Arturrito63/4Channel-DVM/Documents/encoder mode.jpg

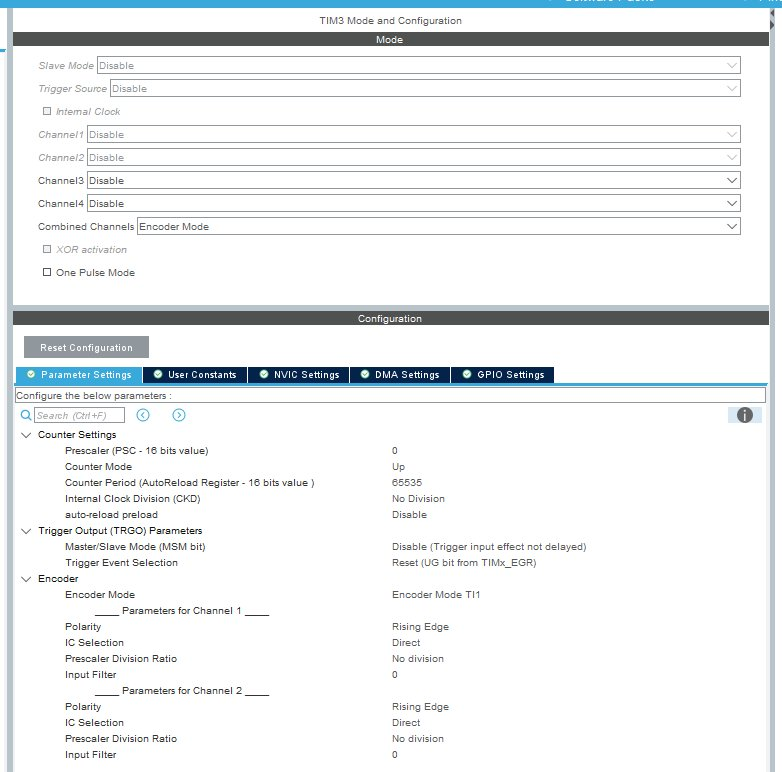
Documents/encoder mode.jpg
