Arturrito63/4Channel-DVM/Documents/ILI3941 timing.jpg

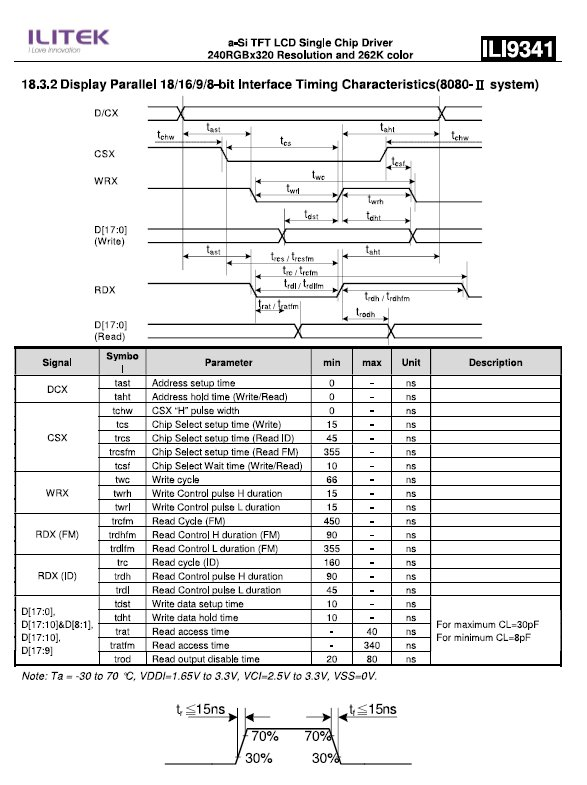
Documents/ILI3941 timing.jpg
