Arturrito63/4Channel-DVM/Documents/MLT024Q50-T6.png

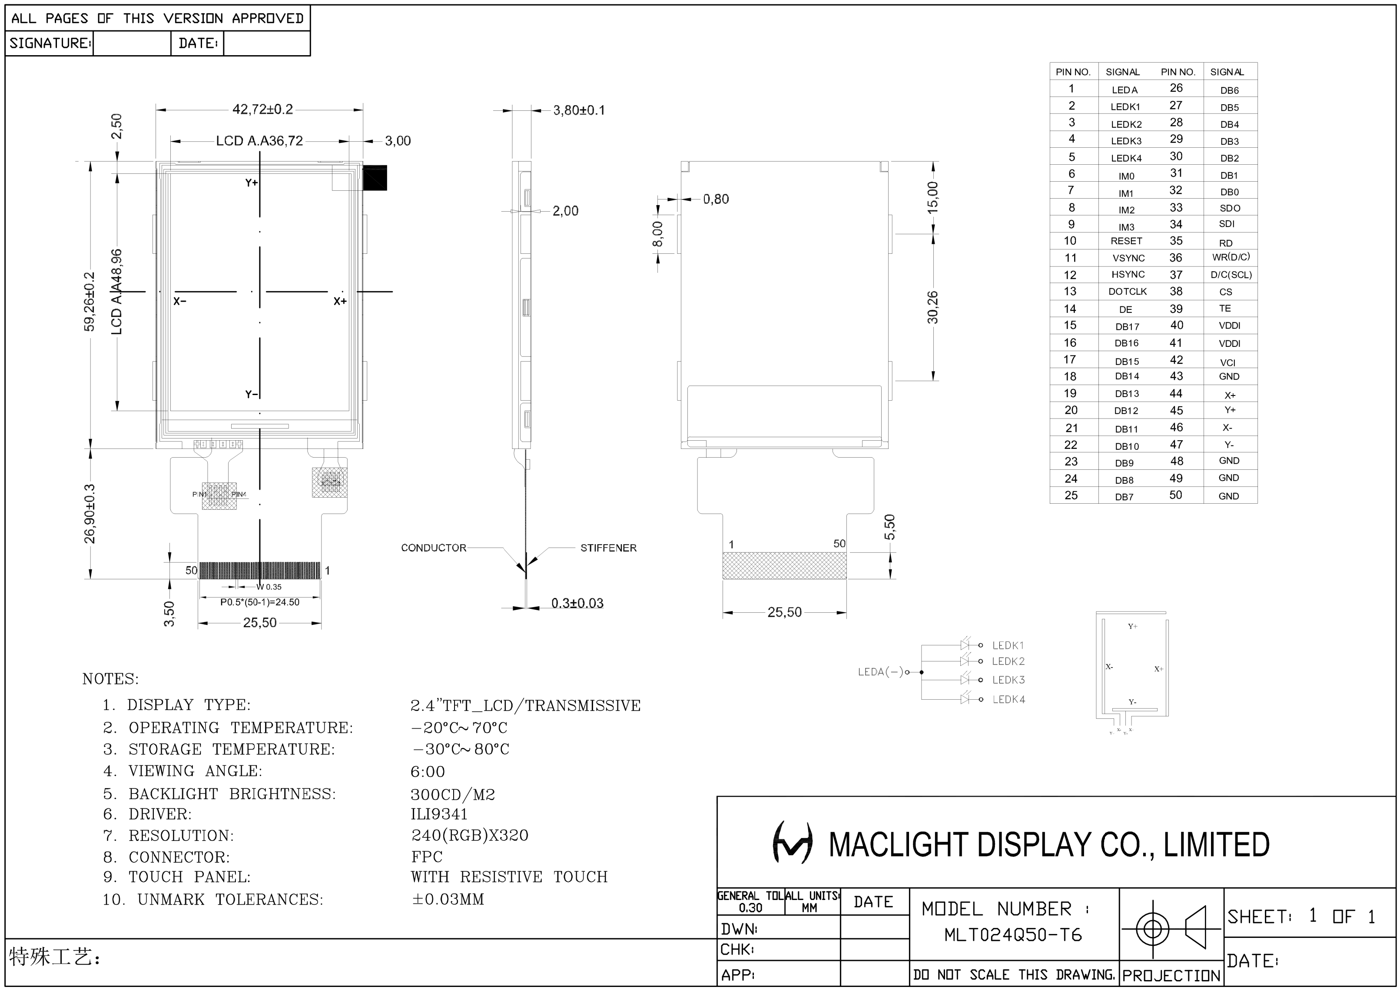
Documents/MLT024Q50-T6.png
