Arturrito63/4Channel-DVM/Documents/STM32F103-Blue-Pill.pdf

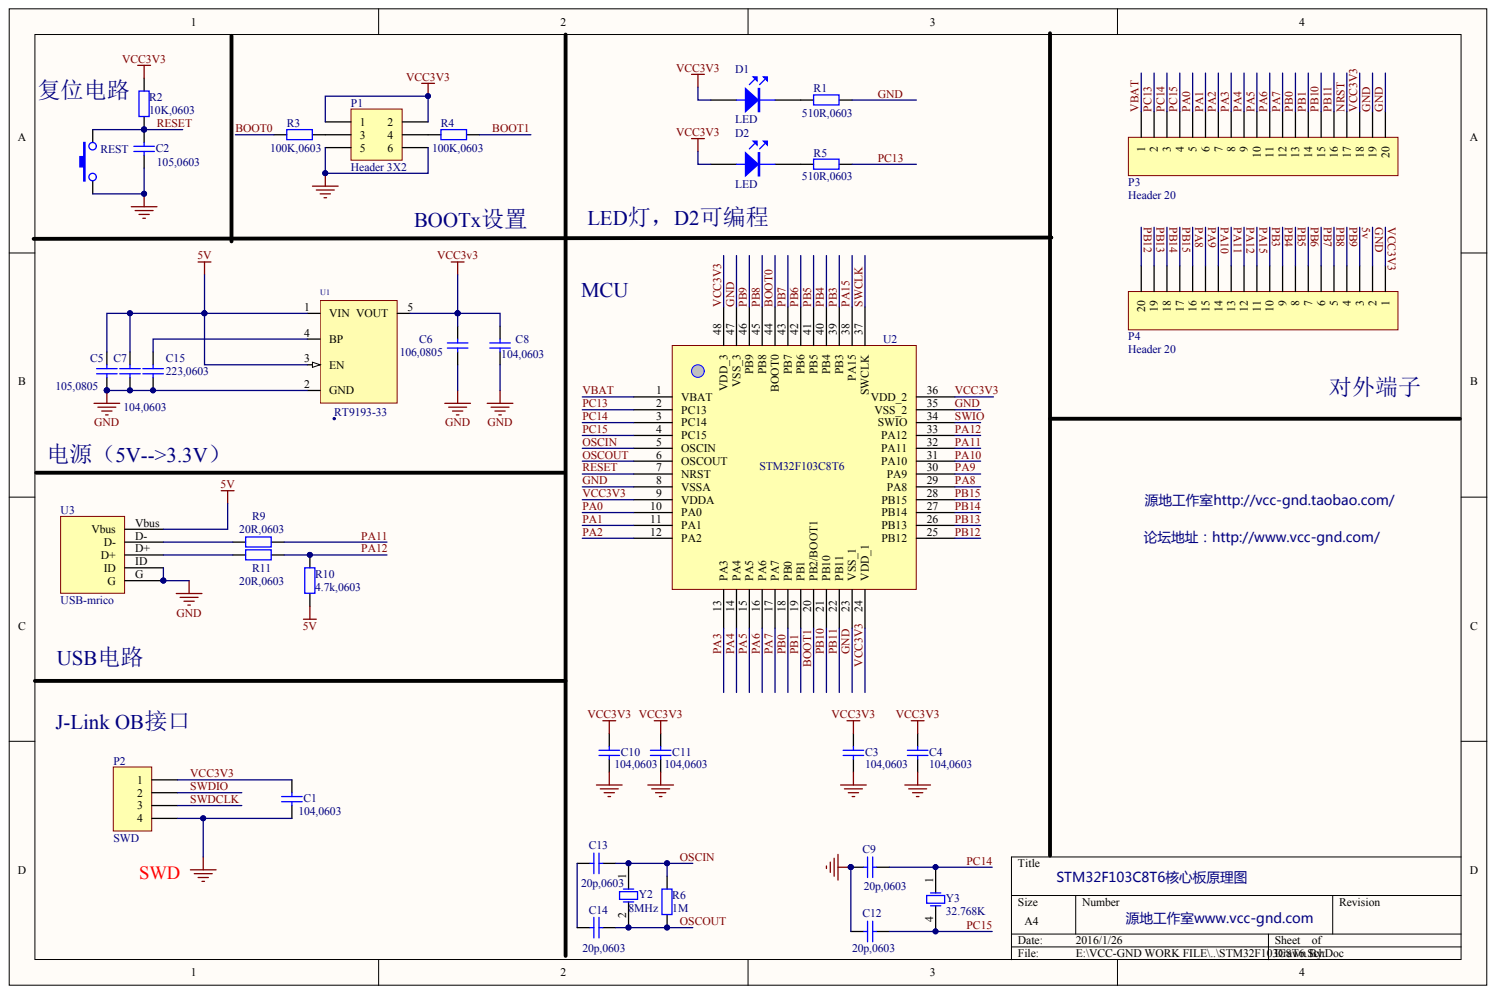
[picture p10: page 1]

源地工作室http://vcc-gnd.taobao.com/

论坛地址：http://www.vcc-gnd.com/

源地工作室www.vcc-gnd.com
