Arturrito63/4Channel-DVM/Documents/4-Channel-DVM.pdf

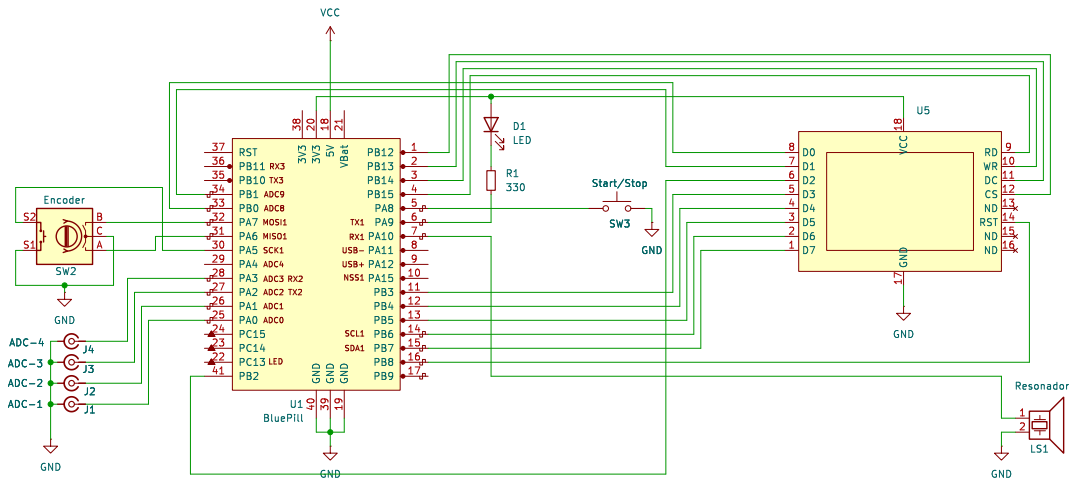
[picture p11: page 1]
