Arturrito63/4Channel-DVM/Documents/ILI9341-ciclos.pdf

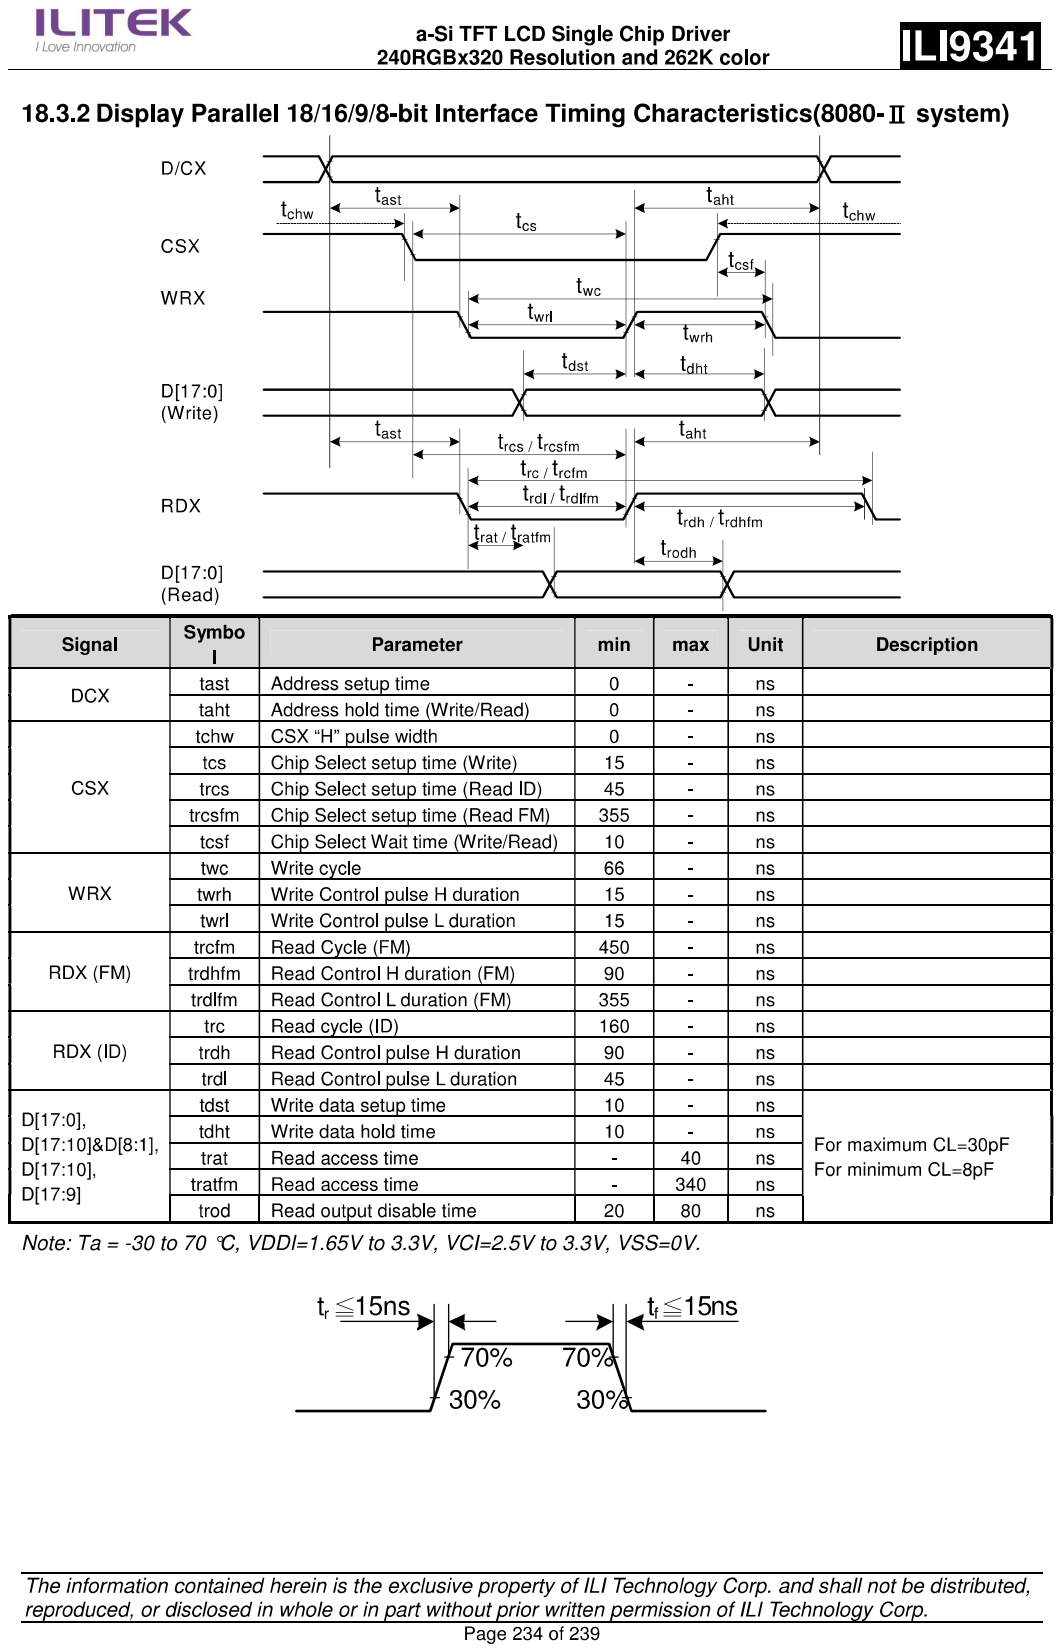
[picture p12: page 1]
