Arturrito63/4Channel-DVM/4Channel-DVM.ioc

Mcu.UserName=STM32F103C8Tx
PA13.Signal=SYS_JTMS-SWDIO
PA14.Signal=SYS_JTCK-SWCLK
PB0.Signal=ADCx_IN8
PB1.Signal=ADCx_IN9
PB12.GPIO_Label=BOTON
PB12.Signal=GPXTI12
PB13.GPIO_Label=ENC-B
PB13.Signal=GPXTI13
PB14.GPIO_Label=ENC-A
PB14.Signal=GPXTI14
PC13-TAMPER-RTC.GPIO_Label=LED
PC13-TAMPER-RTC.Signal=GPIO_Output
PC14-OSC32_IN.Signal=RCC_OSC32_IN
PC15-OSC32_OUT.Signal=RCC_OSC32_OUT
PD0-OSC_IN.Signal=RCC_OSC_IN
PD1-OSC_OUT.Signal=RCC_OSC_OUT
