Arturrito63/4Channel-DVM/Core/Inc/main.h

#define LED_Pin GPIO_PIN_13
#define LED_GPIO_Port GPIOC
#define BOTON_Pin GPIO_PIN_5
#define BOTON_GPIO_Port GPIOA
#define BOTON_EXTI_IRQn EXTI9_5_IRQn
#define ENC_A_Pin GPIO_PIN_6
#define ENC_A_GPIO_Port GPIOA
#define ENC_B_Pin GPIO_PIN_7
#define ENC_B_GPIO_Port GPIOA
#define START_Pin GPIO_PIN_8
#define START_GPIO_Port GPIOA
#define START_EXTI_IRQn EXTI9_5_IRQn
#define LED_START_Pin GPIO_PIN_9
#define LED_START_GPIO_Port GPIOA
#define BEEP_Pin GPIO_PIN_10
#define BEEP_GPIO_Port GPIOA
