Arturrito63/4Channel-DVM/Core/Src/ili9341_parallel.c

/*
MIT License

Copyright (c) 2020 Avra Mitra

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
THE SOFTWARE IS PROVIDED "AS IS", WITHOUT WARRANTY OF ANY KIND, EXPRESS OR
IMPLIED, INCLUDING BUT NOT LIMITED TO THE WARRANTIES OF MERCHANTABILITY,
FITNESS FOR A PARTICULAR PURPOSE AND NONINFRINGEMENT. IN NO EVENT SHALL THE
AUTHORS OR COPYRIGHT HOLDERS BE LIABLE FOR ANY CLAIM, DAMAGES OR OTHER
LIABILITY, WHETHER IN AN ACTION OF CONTRACT, TORT OR OTHERWISE, ARISING FROM,
OUT OF OR IN CONNECTION WITH THE SOFTWARE OR THE USE OR OTHER DEALINGS IN THE
SOFTWARE.
*/

#include <stdlib.h>
#include <ili9341_parallel.h>

//TFT width and height default global variables
uint16_t ili_tftwidth = 240;
uint16_t ili_tftheight = 320;



/**
 * Set an area for drawing on the display with start row,col and end row,col.
 * User don't need to call it usually, call it only before some functions who don't call it by default.
 * @param x1 start column address.
 * @param y1 start row address.
 * @param x2 end column address.
 * @param y2 end row address.
 */
void ili_set_address_window(uint16_t x1, uint16_t y1, uint16_t x2, uint16_t y2)
{
	_ili_write_command_8bit(ILI_CASET);

	ILI_DC_DAT;
	ILI_WRITE_8BIT((uint8_t)(x1 >> 8));
	ILI_WRITE_8BIT((uint8_t)x1);
	ILI_WRITE_8BIT((uint8_t)(x2 >> 8));
	ILI_WRITE_8BIT((uint8_t)x2);


	_ili_write_command_8bit(ILI_PASET);
	ILI_DC_DAT;
	ILI_WRITE_8BIT((uint8_t)(y1 >> 8));
	ILI_WRITE_8BIT((uint8_t)y1);
	ILI_WRITE_8BIT((uint8_t)(y2 >> 8));
	ILI_WRITE_8BIT((uint8_t)y2);

	_ili_write_command_8bit(ILI_RAMWR);
}



/*
 * Render a character glyph on the display. Called by `_ili_draw_string_main()`
 * User need NOT call it
 */
void _ili_render_glyph(uint16_t x, uint16_t y, uint16_t fore_color, uint16_t back_color, const tImage *glyph, uint8_t is_bg)
{
	uint16_t width = 0, height = 0;

	width = glyph->width;
	height = glyph->height;

	uint16_t temp_x = x;
	uint16_t temp_y = y;

	uint8_t mask = 0x80;
	uint8_t bit_counter = 0;

	const uint8_t *glyph_data_ptr = (const uint8_t *)(glyph->data);
	uint8_t glyph_data = 0;

	// font bitmaps are stored in column major order (scanned from left-to-right, not the conventional top-to-bottom)
	// as font glyphs have heigher height than width, this scanning saves some storage.
	// So, we also render in left-to-right manner.

	// Along x axis (width)
	for (int i = 0; i < width; i++)
	{
		// Along y axis (height)
		for (int j = 0; j < height; j++)
		{

			// load new data only when previous byte (or word, depends on glyph->dataSize) is completely traversed by the mask
			// bit_counter = 0 means glyph_data is completely traversed by the mask
			if (bit_counter == 0)
			{
				glyph_data = *glyph_data_ptr++;
				bit_counter = glyph->dataSize;
			}
			// Decrement bit counter
			bit_counter--;

			//If pixel is blank
			if (glyph_data & mask)
			{
				//Has background color (not transparent bg)
				if (is_bg)
				{
					ili_draw_pixel(temp_x, temp_y, back_color);
				}
			}

			//if pixel is not blank
			else
			{
				ili_draw_pixel(temp_x, temp_y, fore_color);
			}

			glyph_data <<= 1;
			temp_y++;
		}

		//New col starts. So, row is set to initial value and col is increased by one
		temp_y = y;
		temp_x++;

		//Reset the bit counter cause we're moving to next column, so we start with a new byte
		bit_counter = 0;
	}
}



/**
 * Renders a string by drawing each character glyph from the passed string.
 * Called by `ili_draw_string()` and `ili_draw_string_withbg()`.
 * Text is wrapped automatically if it hits the screen boundary.
 * x_padding and y_padding defines horizontal and vertical distance (in px) between two characters
 * is_bg=1 : Text will habe background color,   is_bg=0 : Text will have transparent background
 * User need NOT call it.
 */

void _ili_draw_string_main(uint16_t x, uint16_t y, char *str, uint16_t fore_color, uint16_t back_color, const tFont *font, uint8_t is_bg)
{
	uint16_t x_temp = x;
	uint16_t y_temp = y;

	uint8_t x_padding = 0;
	uint8_t y_padding = 0;
	const tImage *img = {0};
	uint16_t width = 0, height = 0;



	while (*str)
	{
		if (*str == '\n')
		{
			x_temp = x;					//go to first col
			y_temp += (font->chars[0].image->height + y_padding);	//go to next row (row height = height of space)
		}

		else if (*str == '\t')
		{
			x_temp += 4 * (font->chars[0].image->height + y_padding);	//Skip 4 spaces (width = width of space)
		}
		else
		{
			for (uint8_t i = 0; i < font->length; i++)
			{
				if (font->chars[i].code == *str)
				{
					img = font->chars[i].image;
					break;
				}
			}
			// No glyph (img) found, so return from this function
			if (img == NULL)
			{
				return;
			}

			width = img->width;
			height = img->height;

			if(y_temp + (height + y_padding) > ili_tftheight - 1)	//not enough space available at the bottom
				return;
			if (x_temp + (width + x_padding) > ili_tftwidth - 1)	//not enough space available at the right side
			{
				x_temp = x;					//go to first col
				y_temp += (height + y_padding);	//go to next row
			}


			if (is_bg)
				_ili_render_glyph(x_temp, y_temp, fore_color, back_color, img, 1);
			else
				_ili_render_glyph(x_temp, y_temp, fore_color, back_color, img, 0);
			x_temp += (width + x_padding);		//next char position
		}


		str++;
	}
}


/**
 * Draws a character at a given position, fore color, back color.
 * @param x Start col address
 * @param y Start row address
 * @param character the ASCII character to be drawn
 * @param fore_color foreground color
 * @param back_color background color
 * @param font Pointer to the font of the character
 * @param is_bg Defines if character has background or not (transparent)
 */
void ili_draw_char(uint16_t x, uint16_t y, char character, uint16_t fore_color, uint16_t back_color, const tFont *font, uint8_t is_bg)
{
	const tImage *img = NULL;
	for (uint8_t i = 0; i < font->length; i++)
	{
		if (font->chars[i].code == character)
		{
			img = font->chars[i].image;
			break;
		}
	}
	// No glyph (img) found, so return from this function
	if (img == NULL)
	{
		return;
	}
	if (is_bg)
		_ili_render_glyph(x, y, fore_color, back_color, img, 1);
	else
		_ili_render_glyph(x, y, fore_color, back_color, img, 0);
}


/**
 * Draws a string on the display with `font` and `color` at given position.
 * Background of this string is transparent
 * @param x Start col address
 * @param y Start y address
 * @param str pointer to the string to be drawn
 * @param color 16-bit RGB565 color of the string
 * @param font Pointer to the font of the string
 */
void ili_draw_string(uint16_t x, uint16_t y, char *str, uint16_t color, const tFont *font)
{
	_ili_draw_string_main(x, y, str, color, 0, font, 0);
}


/**
 * Draws a string on the display with `font`, `fore_color`, and `back_color` at given position.
 * The string has background color
 * @param x Start col address
 * @param y Start y address
 * @param str pointer to the string to be drawn
 * @param foe_color 16-bit RGB565 color of the string
 * @param back_color 16-bit RGB565 color of the string's background
 * @param font Pointer to the font of the string
 */
void ili_draw_string_withbg(uint16_t x, uint16_t y, char *str, uint16_t fore_color, uint16_t back_color, const tFont *font)
{
	_ili_draw_string_main(x, y, str, fore_color, back_color, font, 1);
}


/**
 * Draw a bitmap image on the display
 * @param x Start col address
 * @param y Start row address
 * @param bitmap Pointer to the image data to be drawn
 */
// void ili_draw_bitmap_old(uint16_t x, uint16_t y, const tImage16bit *bitmap)
// {
// 	uint16_t width = 0, height = 0;
// 	width = bitmap->width;
// 	height = bitmap->height;

// 	uint16_t total_pixels = width * height;

// 	ili_set_address_window(x, y, x + width-1, y + height-1);

// 	ILI_DC_DAT;
// 	for (uint16_t pixels = 0; pixels < total_pixels; pixels++)
// 	{
// 		ILI_WRITE_8BIT((uint8_t)(bitmap->data[pixels] >> 8));
// 		ILI_WRITE_8BIT((uint8_t)bitmap->data[pixels]);
// 	}
// }

void ili_draw_bitmap(uint16_t x, uint16_t y, const tImage *bitmap)
{
	uint16_t width = 0, height = 0;
	width = bitmap->width;
	height = bitmap->height;

	uint16_t total_pixels = width * height;

	ili_set_address_window(x, y, x + width-1, y + height-1);

	ILI_DC_DAT;
	for (uint16_t pixels = 0; pixels < total_pixels; pixels++)
	{
		ILI_WRITE_8BIT((uint8_t)(bitmap->data[2*pixels]));
		ILI_WRITE_8BIT((uint8_t)(bitmap->data[2*pixels + 1]));
	}
}


/**
 * Fills `len` number of pixels with `color`.
 * Call ili_set_address_window() before calling this function.
 * @param color 16-bit RGB565 color value
 * @param len 32-bit number of pixels
 */
void ili_fill_color(uint16_t color, uint32_t len)
{
	/*
	* Here, macros are directly called (instead of inline functions) for performance increase
	*/
	uint16_t blocks = (uint16_t)(len / 64); // 64 pixels/block
	uint8_t  pass_count;
	uint8_t color_high = color >> 8;
	uint8_t color_low = color;

	ILI_DC_DAT;
	// Write first pixel
	ILI_WRITE_8BIT(color_high); ILI_WRITE_8BIT(color_low);
	len--;

	// If higher byte and lower byte are identical,
	// just strobe the WR pin to send the previous data
	if(color_high == color_low)
	{
		while(blocks--)
		{
			// pass count = number of blocks / pixels per pass = 64 / 4
			pass_count = 16;
			while(pass_count--)
			{
				ILI_WR_STROBE; ILI_WR_STROBE; ILI_WR_STROBE; ILI_WR_STROBE; // 2
				ILI_WR_STROBE; ILI_WR_STROBE; ILI_WR_STROBE; ILI_WR_STROBE; // 4
			}
		}
		// Fill any remaining pixels (1 to 64)
		pass_count = len & 63;
		while (pass_count--)
		{
			ILI_WR_STROBE; ILI_WR_STROBE;
		}
	}

	// If higher and lower bytes are different, send those bytes
	else
	{
		while(blocks--)
		{
			pass_count = 16;
			while(pass_count--)
			{
				ILI_WRITE_8BIT(color_high); ILI_WRITE_8BIT(color_low); 	ILI_WRITE_8BIT(color_high); ILI_WRITE_8BIT(color_low); //2
				ILI_WRITE_8BIT(color_high); ILI_WRITE_8BIT(color_low); 	ILI_WRITE_8BIT(color_high); ILI_WRITE_8BIT(color_low); //4
			}
		}
		pass_count = len & 63;
		while (pass_count--)
		{
			// write here the remaining data
			ILI_WRITE_8BIT(color_high); ILI_WRITE_8BIT(color_low);
		}
	}
}


/**
 * Fills a rectangular area with `color`.
 * Before filling, performs area bound checking
 * @param x Start col address
 * @param y Start row address
 * @param w Width of rectangle
 * @param h Height of rectangle
 * @param color 16-bit RGB565 color
 */
void ili_fill_rect(uint16_t x, uint16_t y, uint16_t w, uint16_t h, uint16_t color)
{
	if (x >= ili_tftwidth || y >= ili_tftheight || w == 0 || h == 0)
		return;
	if (x + w - 1 >= ili_tftwidth)
		w = ili_tftwidth - x;
	if (y + h - 1 >= ili_tftheight)
		h = ili_tftheight - y;

	ili_set_address_window(x, y, x + w - 1, y + h - 1);
	ili_fill_color(color, (uint32_t)w * (uint32_t)h);
}


/*
 * Same as `ili_fill_rect()` but does not do bound checking, so it's slightly faster
 */
void ili_fill_rect_fast(uint16_t x1, uint16_t y1, uint16_t w, uint16_t h, uint16_t color)
{
	ili_set_address_window(x1, y1, x1 + w - 1, y1 + h - 1);
	ili_fill_color(color, (uint32_t)w * (uint32_t)h);
}


/**
 * Fill the entire display (screen) with `color`
 * @param color 16-bit RGB565 color
 */
void ili_fill_screen(uint16_t color)
{
	ili_set_address_window(0, 0, ili_tftwidth - 1, ili_tftheight - 1);
	ili_fill_color(color, (uint32_t)ili_tftwidth * (uint32_t)ili_tftheight);
}


/**
 * Draw a rectangle
*/
void ili_draw_rectangle(uint16_t x, uint16_t y, uint16_t w, uint16_t h, uint16_t color)
{
	// Perform bound checking
	if (x >= ili_tftwidth || y >= ili_tftheight || w == 0 || h == 0)
		return;
	if (x + w - 1 >= ili_tftwidth)
		w = ili_tftwidth - x;
	if (y + h - 1 >= ili_tftheight)
		h = ili_tftheight - y;

	_ili_draw_fast_h_line(x, y, x+w-1, 1, color);
	_ili_draw_fast_h_line(x, y+h, x+w-1, 1, color);
	_ili_draw_fast_v_line(x, y, y+h-1, 1, color);
	_ili_draw_fast_v_line(x+w, y, y+h-1, 1, color);


}

/*
 * Called by ili_draw_line().
 * User need not call it
 */
void _ili_plot_line_low(uint16_t x0, uint16_t y0, uint16_t x1, uint16_t y1, uint8_t width, uint16_t color)
{
	int16_t dx = x1 - x0;
	int16_t dy = y1 - y0;
	int8_t yi = 1;
	uint8_t pixels_per_point = width * width;	//no of pixels making a point. if line width is 1, this var is 1. if 2, this var is 4 and so on
	uint8_t color_high = (uint8_t)(color >> 8);
	uint8_t color_low = (uint8_t)color;
	if (dy < 0)
	{
		yi = -1;
		dy = -dy;
	}

	int16_t D = 2*dy - dx;
	uint16_t y = y0;
	uint16_t x = x0;

	while (x <= x1)
	{
		ili_set_address_window(x, y, x+width-1, y+width-1);
		//Drawing all the pixels of a single point

		ILI_DC_DAT;
		for (uint8_t pixel_cnt = 0; pixel_cnt < pixels_per_point; pixel_cnt++)
		{
			ILI_WRITE_8BIT(color_high);
			ILI_WRITE_8BIT(color_low);
		}
		if (D > 0)
		{
			y = y + yi;
			D = D - 2*dx;
		}
		D = D + 2*dy;
		x++;
	}
}


/*
 * Called by ili_draw_line().
 * User need not call it
 */
void _ili_plot_line_high(uint16_t x0, uint16_t y0, uint16_t x1, uint16_t y1, uint8_t width, uint16_t color)
{
	int16_t dx = x1 - x0;
	int16_t dy = y1 - y0;
	int8_t xi = 1;
	uint8_t pixels_per_point = width * width;	//no of pixels making a point. if line width is 1, this var is 1. if 2, this var is 4 and so on
	uint8_t color_high = (uint8_t)(color >> 8);
	uint8_t color_low = (uint8_t)color;

	if (dx < 0)
	{
		xi = -1;
		dx = -dx;
	}

	int16_t D = 2*dx - dy;
	uint16_t y = y0;
	uint16_t x = x0;

	while (y <= y1)
	{
		ili_set_address_window(x, y, x+width-1, y+width-1);
		//Drawing all the pixels of a single point

		ILI_DC_DAT;
		for (uint8_t pixel_cnt = 0; pixel_cnt < pixels_per_point; pixel_cnt++)
		{
			ILI_WRITE_8BIT(color_high);
			ILI_WRITE_8BIT(color_low);
		}
		if (D > 0)
		{
			x = x + xi;
			D = D - 2*dy;
		}
		D = D + 2*dx;
		y++;
	}
}


/**
 * Draw a line from (x0,y0) to (x1,y1) with `width` and `color`.
 * @param x0 start column address.
 * @param y0 start row address.
 * @param x1 end column address.
 * @param y1 end row address.
 * @param width width or thickness of the line
 * @param color 16-bit RGB565 color of the line
 */
void ili_draw_line(uint16_t x0, uint16_t y0, uint16_t x1, uint16_t y1, uint8_t width, uint16_t color)
{
	/*
	* Brehensen's algorithm is used.
	* Not necessarily start points has to be less than end points.
	*/

	if (x0 == x1)	//vertical line
	{
		_ili_draw_fast_v_line(x0, y0, y1, width, color);
	}
	else if (y0 == y1)		//horizontal line
	{
		_ili_draw_fast_h_line(x0, y0, x1, width, color);
	}

	else
	{
		if (abs(y1 - y0) < abs(x1 - x0))
		{
			if (x0 > x1)
				_ili_plot_line_low(x1, y1, x0, y0, width, color);
			else
				_ili_plot_line_low(x0, y0, x1, y1, width, color);
		}

		else
		{
			if (y0 > y1)
				_ili_plot_line_high(x1, y1, x0, y0, width, color);
			else
				_ili_plot_line_high(x0, y0, x1, y1, width, color) ;
		}
	}

}


/*
 * Called by ili_draw_line().
 * User need not call it
 */
void _ili_draw_fast_h_line(uint16_t x0, uint16_t y0, uint16_t x1, uint8_t width, uint16_t color)
{
	/*
	* Draw a horizontal line very fast
	*/
	if (x0 < x1)
		ili_set_address_window(x0, y0, x1, y0+width-1);	//as it's horizontal line, y1=y0.. must be.
	else
		ili_set_address_window(x1, y0, x0, y0+width-1);	
	ili_fill_color(color, (uint32_t)width * (uint32_t)abs(x1 - x0 + 1));
}


/*
 * Called by ili_draw_line().
 * User need not call it
 */
void _ili_draw_fast_v_line(uint16_t x0, uint16_t y0, uint16_t y1, uint8_t width, uint16_t color)
{
	/*
	* Draw a vertical line very fast
	*/
	if (y0 < y1)
		ili_set_address_window(x0, y0, x0+width-1, y1);	//as it's vertical line, x1=x0.. must be.
	else
		ili_set_address_window(x0, y1, x0+width-1, y0);	
	
	
	ili_fill_color(color, (uint32_t)width * (uint32_t)abs(y1 - y0 + 1));
}


/**
 * Draw a pixel at a given position with `color`
 * @param x Start col address
 * @param y Start row address
 */
void ili_draw_pixel(uint16_t x, uint16_t y, uint16_t color)
{
	/*
	* Why?: This function is mainly added in the driver so that  ui libraries can use it.
	* example: LittlevGL requires user to supply a function that can draw pixel
	*/

	ili_set_address_window(x, y, x, y);
	ILI_DC_DAT;
	ILI_WRITE_8BIT((uint8_t)(color >> 8));
	ILI_WRITE_8BIT((uint8_t)color);
}



/**
 * Rotate the display clockwise or anti-clockwie set by `rotation`
 * @param rotation Type of rotation. Supported values 0, 1, 2, 3
 */
void ili_rotate_display(uint8_t rotation)
{
	/*
	* 	(uint8_t)rotation :	Rotation Type
	* 					0 : Default landscape
	* 					1 : Potrait 1
	* 					2 : Landscape 2
	* 					3 : Potrait 2
	*/

    uint16_t new_height = 320;
    uint16_t new_width = 240;
	switch (rotation)
	{
		case 0:
			_ili_write_command_8bit(ILI_MADCTL);		//Memory Access Control
			_ili_write_data_8bit(0x48);	 			//MX: 1, MY: 0, MV: 0	(Landscape 1. Default)
			ili_tftheight = new_height;
			ili_tftwidth = new_width;
			break;
		case 1:
			_ili_write_command_8bit(ILI_MADCTL);		//Memory Access Control
			_ili_write_data_8bit(0x28);				//MX: 0, MY: 0, MV: 1	(Potrait 1)
			ili_tftheight = new_width;
			ili_tftwidth = new_height;
			break;
		case 2:
			_ili_write_command_8bit(ILI_MADCTL);		//Memory Access Control
			_ili_write_data_8bit(0x88);				//MX: 0, MY: 1, MV: 0	(Landscape 2)
			ili_tftheight = new_height;
			ili_tftwidth = new_width;
			break;
		case 3:
			_ili_write_command_8bit(ILI_MADCTL);		//Memory Access Control
			_ili_write_data_8bit(0xE8);				//MX: 1, MY: 1, MV: 1	(Potrait 2)
			ili_tftheight = new_width;
			ili_tftwidth = new_height;
			break;
	}
}

/**
 * Initialize the display driver
 */
void ili_init()
{
	// Configure gpio output dir and mode
	ILI_CONFIG_GPIO();

	ILI_RD_IDLE;
	ILI_WR_IDLE;
	ILI_CS_ACTIVE;

	ILI_RST_IDLE;
	ILI_RST_ACTIVE;
	ILI_RST_IDLE;

	HAL_Delay(10);

	// Approx 10ms delay at 128MHz clock
	//for (uint32_t i = 0; i < 2000000; i++)
	//	__asm__("nop");

	_ili_write_data_8bit(ILI_SWRESET);
	HAL_Delay(10);
	_ili_write_data_8bit(ILI_DISPOFF);

/*	_ili_write_command_8bit(0xEF);
	_ili_write_data_8bit(0x03);
	_ili_write_data_8bit(0x80);
	_ili_write_data_8bit(0x02);

	_ili_write_command_8bit(0xCF);
	_ili_write_data_8bit(0x00);
	_ili_write_data_8bit(0XC1);
	_ili_write_data_8bit(0X30);

	_ili_write_command_8bit(0xED);
	_ili_write_data_8bit(0x64);
	_ili_write_data_8bit(0x03);
	_ili_write_data_8bit(0X12);
	_ili_write_data_8bit(0X81);

	_ili_write_command_8bit(0xE8);
	_ili_write_data_8bit(0x85);
	_ili_write_data_8bit(0x00);
	_ili_write_data_8bit(0x78);

	_ili_write_command_8bit(0xCB);
	_ili_write_data_8bit(0x39);
	_ili_write_data_8bit(0x2C);
	_ili_write_data_8bit(0x00);
	_ili_write_data_8bit(0x34);
	_ili_write_data_8bit(0x02);

	_ili_write_command_8bit(0xF7);
	_ili_write_data_8bit(0x20);

	_ili_write_command_8bit(0xEA);
	_ili_write_data_8bit(0x00);
	_ili_write_data_8bit(0x00);
*/
	_ili_write_command_8bit(ILI_PWCTR1);    //Power control
	_ili_write_data_8bit(0x23);   //VRH[5:0]

	_ili_write_command_8bit(ILI_PWCTR2);    //Power control
	_ili_write_data_8bit(0x10);   //SAP[2:0];BT[3:0]

	_ili_write_command_8bit(ILI_VMCTR1);    //VCM control
	//_ili_write_data_8bit(0x3e);
	//_ili_write_data_8bit(0x28);
	_ili_write_data_16bit(0x2B2B);


	_ili_write_command_8bit(ILI_VMCTR2);    //VCM control2
	//_ili_write_data_8bit(0x86);  //--
	_ili_write_data_8bit(0xC0);

	_ili_write_command_8bit(ILI_MADCTL);    // Memory Access Control
	_ili_write_data_8bit(0x88); // Rotation 0 (landscape mode)

	//_ili_write_command_8bit(ILI_VSCRSADD);
	//_ili_write_data_8bit(0x00);

	_ili_write_command_8bit(ILI_PIXFMT);
	_ili_write_data_8bit(0x55);

	_ili_write_command_8bit(ILI_FRMCTR1);
	_ili_write_data_16bit(0x001B); // 0x18 79Hz, 0x1B default 70Hz, 0x13 100Hz

	_ili_write_command_8bit(ILI_ENTRYMODE);
	_ili_write_data_8bit(0x07);

	_ili_write_command_8bit(ILI_DFUNCTR);
	_ili_write_data_16bit(0x0A82);
	_ili_write_data_16bit(0x2700);

/*
	_ili_write_command_8bit(ILI_DFUNCTR);    // Display Function Control
	_ili_write_data_8bit(0x08);
	_ili_write_data_8bit(0x82);
	_ili_write_data_8bit(0x27);

	_ili_write_command_8bit(0xF2);    // 3Gamma Function Disable
	_ili_write_data_8bit(0x00);

	_ili_write_command_8bit(ILI_GAMMASET);    //Gamma curve selected
	_ili_write_data_8bit(0x01);

	_ili_write_command_8bit(ILI_GMCTRP1);    //Set Gamma
	_ili_write_data_8bit(0x0F);
	_ili_write_data_8bit(0x31);
	_ili_write_data_8bit(0x2B);
	_ili_write_data_8bit(0x0C);
	_ili_write_data_8bit(0x0E);
	_ili_write_data_8bit(0x08);
	_ili_write_data_8bit(0x4E);
	_ili_write_data_8bit(0xF1);
	_ili_write_data_8bit(0x37);
	_ili_write_data_8bit(0x07);
	_ili_write_data_8bit(0x10);
	_ili_write_data_8bit(0x03);
	_ili_write_data_8bit(0x0E);
	_ili_write_data_8bit(0x09);
	_ili_write_data_8bit(0x00);

	_ili_write_command_8bit(ILI_GMCTRN1);    //Set Gamma
	_ili_write_data_8bit(0x00);
	_ili_write_data_8bit(0x0E);
	_ili_write_data_8bit(0x14);
	_ili_write_data_8bit(0x03);
	_ili_write_data_8bit(0x11);
	_ili_write_data_8bit(0x07);
	_ili_write_data_8bit(0x31);
	_ili_write_data_8bit(0xC1);)
	_ili_write_data_8bit(0x48);
	_ili_write_data_8bit(0x08);
	_ili_write_data_8bit(0x0F);
	_ili_write_data_8bit(0x0C);
	_ili_write_data_8bit(0x31);
	_ili_write_data_8bit(0x36);
	_ili_write_data_8bit(0x0F);
*/
	_ili_write_command_8bit(ILI_SLPOUT);    //Exit Sleep
	HAL_Delay(50);
	//_ili_write_data_8bit(0x80);
	//delay 150ms if display output is inaccurate

	_ili_write_command_8bit(ILI_DISPON);    //Display on
	HAL_Delay(100);
	//_ili_write_data_8bit(0x80);
	//_ili_write_data_8bit(0x00);
	//delay 150ms if display output is inaccurate
	//ILI_CS_IDLE;
}
