Arturrito63/4Channel-DVM/(commit log)

2025-04-14 Inclusión de video de Youtube
2025-04-14 Enlace a video de Youtube
2025-04-14 Subo video de youtube
2025-04-14 Enlace de video actualizado
2025-04-15 Subo carpeta
    Subo carpeta Documents con imágenes, documentos y elimino las de raiz
2025-04-15 Update README.md
    Descripción de montaje
2025-04-15 Update README.md
    Modificando errores de sintaxis
2025-04-15 Update README.md
    Corrección de sintaxis y otras yerbas
2025-04-17 Update README.md
    Corrección de tabla
2025-04-17 Update README.md
    Actualización de archivos y descripción del montaje
2025-04-17 Update README.md
    Corrección de subtitulos
2025-04-19 Update README.md
    Actualizando descripción de montaje
